AberDerBart/Floppotron-Jr/pcb/eurocad/README.md

## Eurocad

Eurorack components and footprints for KiCad.

### Components

- [Eurorack 2x5 Power Header](http://www.doepfer.de/a100_man/a100t_e.htm)
- [HT16K33](https://cdn-shop.adafruit.com/datasheets/ht16K33v110.pdf)
- [LP4OA1PBCT](http://datasheet.elcodis.com/pdf/19/45/194534/lp4oa1pbctr.pdf)
- [MCP23017](https://cdn-shop.adafruit.com/datasheets/mcp23017.pdf)
- [PJ301M-12](https://www.thonk.co.uk/wp-content/uploads/2014/02/Thonkiconn_Jack_Datasheet.pdf)
- [SN74HC165](http://www.ti.com/lit/ds/symlink/sn74hc165.pdf)
- [SN74HC595](http://www.ti.com/lit/ds/symlink/sn74hc595.pdf)
- [TLC5925](http://www.ti.com/lit/ds/symlink/tlc5925.pdf)
- [TL1105SPF250Q](http://spec_sheets.e-switch.com/specs/J100206.pdf)
- [B3W9](http://www.mouser.com/ds/2/307/en-b3w-9-11824.pdf)
- [RGBLED10mm](https://cdn-shop.adafruit.com/datasheets/FLR-100WAS-RGB.pdf)
- [BA56](http://www.kingbrightusa.com/images/catalog/SPEC/BA56-12SRWA.pdf)
- [7805](https://www.sparkfun.com/datasheets/Components/LM7805.pdf)
- 2x8 0.1" Pin Header
- 2x5 0.1" Pin Header
- 2x4 0.1" Pin Header

### Footprints

- [LP4OA1PBCT](http://datasheet.elcodis.com/pdf/19/45/194534/lp4oa1pbctr.pdf)
- [PJ301M-12](https://www.thonk.co.uk/wp-content/uploads/2014/02/Thonkiconn_Jack_Datasheet.pdf)
- [TL1105SPF250Q](http://spec_sheets.e-switch.com/specs/J100206.pdf)
- [B3W9](http://www.mouser.com/ds/2/307/en-b3w-9-11824.pdf)
- [Alpha9mmPot](https://www.thonk.co.uk/documents/alpha/9mm/Alpha%209mm%20Vertical%20-%20Linear%20Taper%20B1M.pdf)
- [RGBLED10mm](https://cdn-shop.adafruit.com/datasheets/FLR-100WAS-RGB.pdf)
- [BA56](http://www.kingbrightusa.com/images/catalog/SPEC/BA56-12SRWA.pdf)
- [DC_JACK](https://www.sparkfun.com/datasheets/Prototyping/Barrel-Connector-PJ-202A.pdf)
- MIDI DIN 5
- Mouse Bites (1mm apart, 0.5mm diameter)
