AberDerBart/Floppotron-Jr/case/case.scad

$fn=32;
FLOPPY_SIZE = [101.6,25.4];
N_FLOPPIES = 6;

D_PIEZO = 30; // 27mm piezo disk + 1.5mm padding

Z_PCB = 10 + FLOPPY_SIZE.y * 6 + 3;
X_BORDER = (125 - FLOPPY_SIZE.x)/2;

module kosmoPanel2d(w, old_hole_style=true) {
  difference(){
    square([w,200]);
    if (old_hole_style) {
      for (p = [
        [5, 5],
        [5, 195],
        [w-5, 5],
        [w-5, 195],
      ]) {
        translate(p) circle(d=3.2);
      }
    }else{
      for (p = [
        [4.5, 3],
        [4.5, 197],
        [w-4.5, 3],
        [w-4.5, 197],
      ]) {
        translate(p) hull(){
          translate([-1.5,0])circle(d=3.2);
          translate([1.5,0])circle(d=3.2);
        }
      }
    }
  }
}

module ports2d(usb=true) {
  // ports on the pcb, measured form the bottom of the PCB
  if(usb) translate([18,0]) 
    // USB port, measured from Pin 1, bottom of PCB
    translate([-7.41, 1.6+0.3])square([12.319, 10.6]);
  translate([37, 1.6+9.75]) circle(d=18);
}

module labels2d() {
  translate([133,187.5]) text("MOD",5, "JetBrainsMono Nerd Font:style=SemiBold", halign="right", valign="center");
  translate([133,162.5]) text("VEL",5, "JetBrainsMono Nerd Font:style=SemiBold", halign="right", valign="center");

  translate([133,112.5]) text("TRIG",5, "JetBrainsMono Nerd Font:style=SemiBold", halign="right", valign="center");
  translate([133,87.5]) text("GATE",5, "JetBrainsMono Nerd Font:style=SemiBold", halign="right", valign="center");

  translate([133,37.5]) text("OUT",5, "JetBrainsMono Nerd Font:style=SemiBold", halign="right", valign="center");
}

module frontPanel2d(interface=false, usb=true) {
  difference(){
    kosmoPanel2d(interface ? 150: 125);
    translate([X_BORDER, 10])square([FLOPPY_SIZE.x, FLOPPY_SIZE.y * N_FLOPPIES]);
    translate([X_BORDER, Z_PCB]) ports2d(usb=usb);
    if (interface) {
      for(y=[25,75,100,150,175]){
        translate([137.5,y]) circle(d=11.2);
      }
      for(y=[87.5,112.5,162.5,187.5]){
        translate([137.5,y]) circle(d=5);
      }
    }
  }
}


module side2d() {
  difference(){
    hull(){
      translate([90,15])circle(r=5);
      translate([85,10 + N_FLOPPIES * FLOPPY_SIZE.y])circle(r=10);
      translate([0, 180])circle(r=10);
      translate([0, 20])circle(r=10);
    }
    for(i = [0:N_FLOPPIES - 1]){
      for(x = [25, 85]){
        translate([x, 5 + 10 + i * FLOPPY_SIZE.y]) circle(d=3);
      }
    }
    translate([-11,0])square([11,200]);
  }
}

module pcbMount2d() {
  difference(){
    union(){
      translate([X_BORDER, 0, 0])square([8.8,95]);
      translate([X_BORDER+FLOPPY_SIZE.x-8.8, 0, 0])square([8.8,95]);
    }
    translate([125/2, 3])
      for(pos = [
        [46, 4],
        [-46, 4],
        [+46, 92 - 4],
        [-46, 92 - 4],
      ])
    {
      translate(pos)circle(d=2.8);
    }
  }
}

module piezoHole2d(){
  circle(d=D_PIEZO);
}

module piezoCover(){
  difference(){
    translate([0,0,3])mirror([0,0,1])linear_extrude(3, scale=1+(2*3/D_PIEZO)){
      difference(){
        piezoHole2d();
        hull(){
          translate([12,0,0])circle(d=5);
          translate([18,0,0])circle(d=6);
        }
      }
    }
  }
}

module cableGuideBridge() {
  translate([0,0,-.5])cube([2,5,1], center=true);
}

module cableGuideHole2d() {
  square([6,3],center=true);
}

module rightWall() {
  module forEachPiezo(){
      for(i = [0:2]){
        translate([48, (1+2*i) * FLOPPY_SIZE.y + 10]) children();
      }
  }

  module forEachCableGuide(){
    for(i = [2:4]){
      translate([75, i * FLOPPY_SIZE.y + 10])children();
    }
  }

  translate([125-X_BORDER,0,0])rotate([90,0,90]){
    linear_extrude(3)difference(){
      side2d();
      forEachPiezo()piezoHole2d();
      forEachCableGuide()cableGuideHole2d();
    }
    translate([0,0,3]){
      forEachPiezo()piezoCover();
      forEachCableGuide()cableGuideBridge();
    }
  }
}

module case(interface = false, usb=true){
  difference(){
    union(){
      rotate([90,0,0])translate([0,0,-3])linear_extrude(3)frontPanel2d(interface=interface, usb=usb);
      translate([X_BORDER-3,0,0])rotate([90,0,90])linear_extrude(3)side2d();
      rightWall();
      translate([0,0,Z_PCB-3])linear_extrude(3)pcbMount2d();
    }
    rotate([90,0,0])translate([0,0,-1])linear_extrude(2)labels2d();
  }
}

case(interface=true, usb=false);
