AberDerBart/Floppotron-Jr/pcb/floppotron/floppotron.kicad_pcb

## KiCad design pcb/floppotron/floppotron.kicad_pcb (2024-12-11)

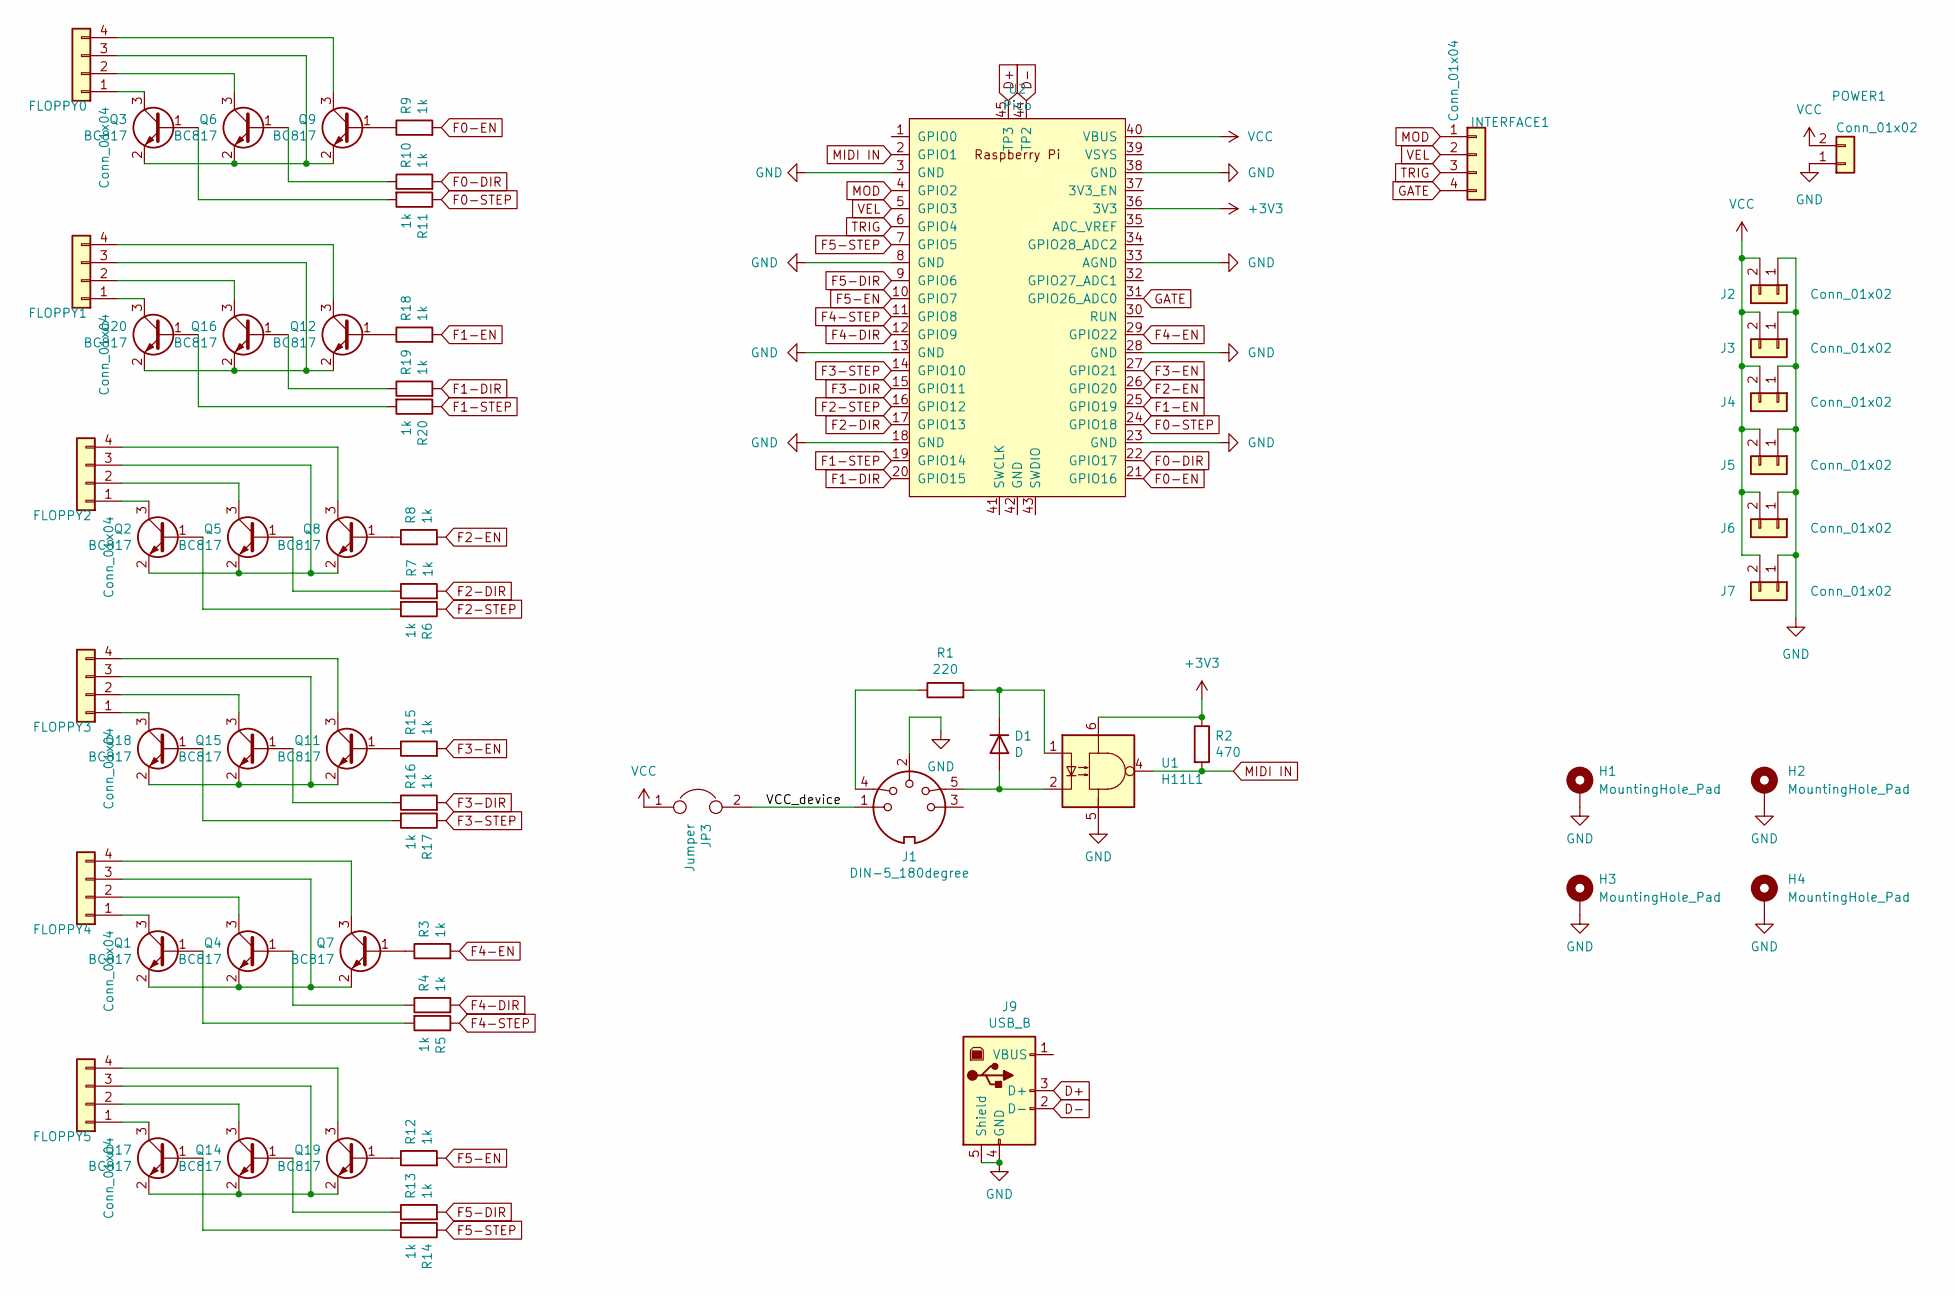
[picture p3: schematic floppotron.kicad_sch]

Parts:
D1: D; D_DO-34_SOD68_P7.62mm_Horizontal
FLOPPY0, FLOPPY1, FLOPPY2, FLOPPY3, FLOPPY4, FLOPPY5: Conn_01x04; JST_XH_B4B-XH-A_1x04_P2.50mm_Vertical
H1, H2, H3, H4: MountingHole_Pad; MountingHole_3.2mm_M3_DIN965_Pad
INTERFACE1: Conn_01x04; JST_XH_B4B-XH-A_1x04_P2.50mm_Vertical
J1: DIN-5_180degree; MIDI_DIN5
J2, J3, J4, J5, J6, J7: Conn_01x02; JST_XH_B2B-XH-A_1x02_P2.50mm_Vertical
J9: USB_B; USB_B_OST_USB-B1HSxx_Horizontal
JP3: Jumper; PinHeader_1x02_P2.54mm_Vertical
POWER1: Conn_01x02; TerminalBlock_bornier-2_P5.08mm
Q1, Q2, Q3, Q4, Q5, Q6, Q7, Q8, Q9, Q11, Q12, Q14, Q15, Q16, Q17, Q18, Q19, Q20: BC817; SOT-23_Handsoldering
R1: 220; R_1206_3216Metric_Pad1.30x1.75mm_HandSolder
R2: 470; R_1206_3216Metric_Pad1.30x1.75mm_HandSolder
R3, R4, R5, R6, R7, R8, R9, R10, R11, R12, R13, R14, R15, R16, R17, R18, R19, R20: 1k; R_1206_3216Metric_Pad1.30x1.75mm_HandSolder
U1: H11L1; DIP-6_W7.62mm_Socket
U2: Pico; RPi_Pico_debug_hole_USB_SMD_TH

Connections:
+3V3: R2.1, U1.6, U2.36 (3V3)
/VCC_device: J1.1, JP3.2
D+: J9.3 (D+), U2.45 (TP3)
D-: J9.2 (D-), U2.44 (TP2)
F0-DIR: R10.2, U2.22 (GPIO17)
F0-EN: R9.2, U2.21 (GPIO16)
F0-STEP: R11.1, U2.24 (GPIO18)
F1-DIR: R19.2, U2.20 (GPIO15)
F1-EN: R18.2, U2.25 (GPIO19)
F1-STEP: R20.1, U2.19 (GPIO14)
F2-DIR: R7.2, U2.17 (GPIO13)
F2-EN: R8.2, U2.26 (GPIO20)
F2-STEP: R6.1, U2.16 (GPIO12)
F3-DIR: R16.2, U2.15 (GPIO11)
F3-EN: R15.2, U2.27 (GPIO21)
F3-STEP: R17.1, U2.14 (GPIO10)
F4-DIR: R4.2, U2.12 (GPIO9)
F4-EN: R3.2, U2.29 (GPIO22)
F4-STEP: R5.1, U2.11 (GPIO8)
F5-DIR: R13.2, U2.9 (GPIO6)
F5-EN: R12.2, U2.10 (GPIO7)
F5-STEP: R14.1, U2.7 (GPIO5)
GATE: INTERFACE1.4, U2.31 (GPIO26_ADC0); also elsewhere on the board
GND: H1.1, H2.1, H3.1, H4.1, J1.2, J2.1, J3.1, J4.1, J5.1, J6.1, J7.1, J9.4 (GND), J9.5 (Shield), POWER1.1, U1.5, U2.3 (GND), U2.8 (GND), U2.13 (GND), U2.18 (GND), U2.23 (GND), U2.28 (GND), U2.33 (AGND), U2.38 (GND)
MIDI IN: R2.2, U1.4, U2.2 (GPIO1)
MOD: INTERFACE1.1, U2.4 (GPIO2); also elsewhere on the board
unnamed: D1.2 (A), J1.5, U1.2
unnamed: D1.1 (K), R1.2, U1.1
unnamed: FLOPPY0.1, Q3.3 (C)
unnamed: FLOPPY0.2, Q6.3 (C)
unnamed: FLOPPY0.3, Q3.2 (E), Q6.2 (E), Q9.2 (E)
unnamed: FLOPPY0.4, Q9.3 (C)
unnamed: FLOPPY1.1, Q20.3 (C)
unnamed: FLOPPY1.2, Q16.3 (C)
unnamed: FLOPPY1.3, Q12.2 (E), Q16.2 (E), Q20.2 (E)
unnamed: FLOPPY1.4, Q12.3 (C)
unnamed: FLOPPY2.1, Q2.3 (C)
unnamed: FLOPPY2.2, Q5.3 (C)
unnamed: FLOPPY2.3, Q2.2 (E), Q5.2 (E), Q8.2 (E)
unnamed: FLOPPY2.4, Q8.3 (C)
unnamed: FLOPPY3.1, Q18.3 (C)
unnamed: FLOPPY3.2, Q15.3 (C)
unnamed: FLOPPY3.3, Q11.2 (E), Q15.2 (E), Q18.2 (E)
unnamed: FLOPPY3.4, Q11.3 (C)
unnamed: FLOPPY4.1, Q1.3 (C)
unnamed: FLOPPY4.2, Q4.3 (C)
unnamed: FLOPPY4.3, Q1.2 (E), Q4.2 (E), Q7.2 (E)
unnamed: FLOPPY4.4, Q7.3 (C)
unnamed: FLOPPY5.1, Q17.3 (C)
unnamed: FLOPPY5.2, Q14.3 (C)
unnamed: FLOPPY5.3, Q14.2 (E), Q17.2 (E), Q19.2 (E)
unnamed: FLOPPY5.4, Q19.3 (C)
unnamed: J1.4, R1.1
unnamed: Q1.1 (B), R5.2
unnamed: Q2.1 (B), R6.2
unnamed: Q3.1 (B), R11.2
unnamed: Q4.1 (B), R4.1
unnamed: Q5.1 (B), R7.1
unnamed: Q6.1 (B), R10.1
unnamed: Q7.1 (B), R3.1
unnamed: Q8.1 (B), R8.1
unnamed: Q9.1 (B), R9.1
unnamed: Q11.1 (B), R15.1
unnamed: Q12.1 (B), R18.1
unnamed: Q14.1 (B), R13.1
unnamed: Q15.1 (B), R16.1
unnamed: Q16.1 (B), R19.1
unnamed: Q17.1 (B), R14.2
unnamed: Q18.1 (B), R17.2
unnamed: Q19.1 (B), R12.1
unnamed: Q20.1 (B), R20.2
TRIG: INTERFACE1.3, U2.6 (GPIO4); also elsewhere on the board
VCC: J2.2, J3.2, J4.2, J5.2, J6.2, J7.2, JP3.1, POWER1.2, U2.40 (VBUS)
VEL: INTERFACE1.2, U2.5 (GPIO3); also elsewhere on the board

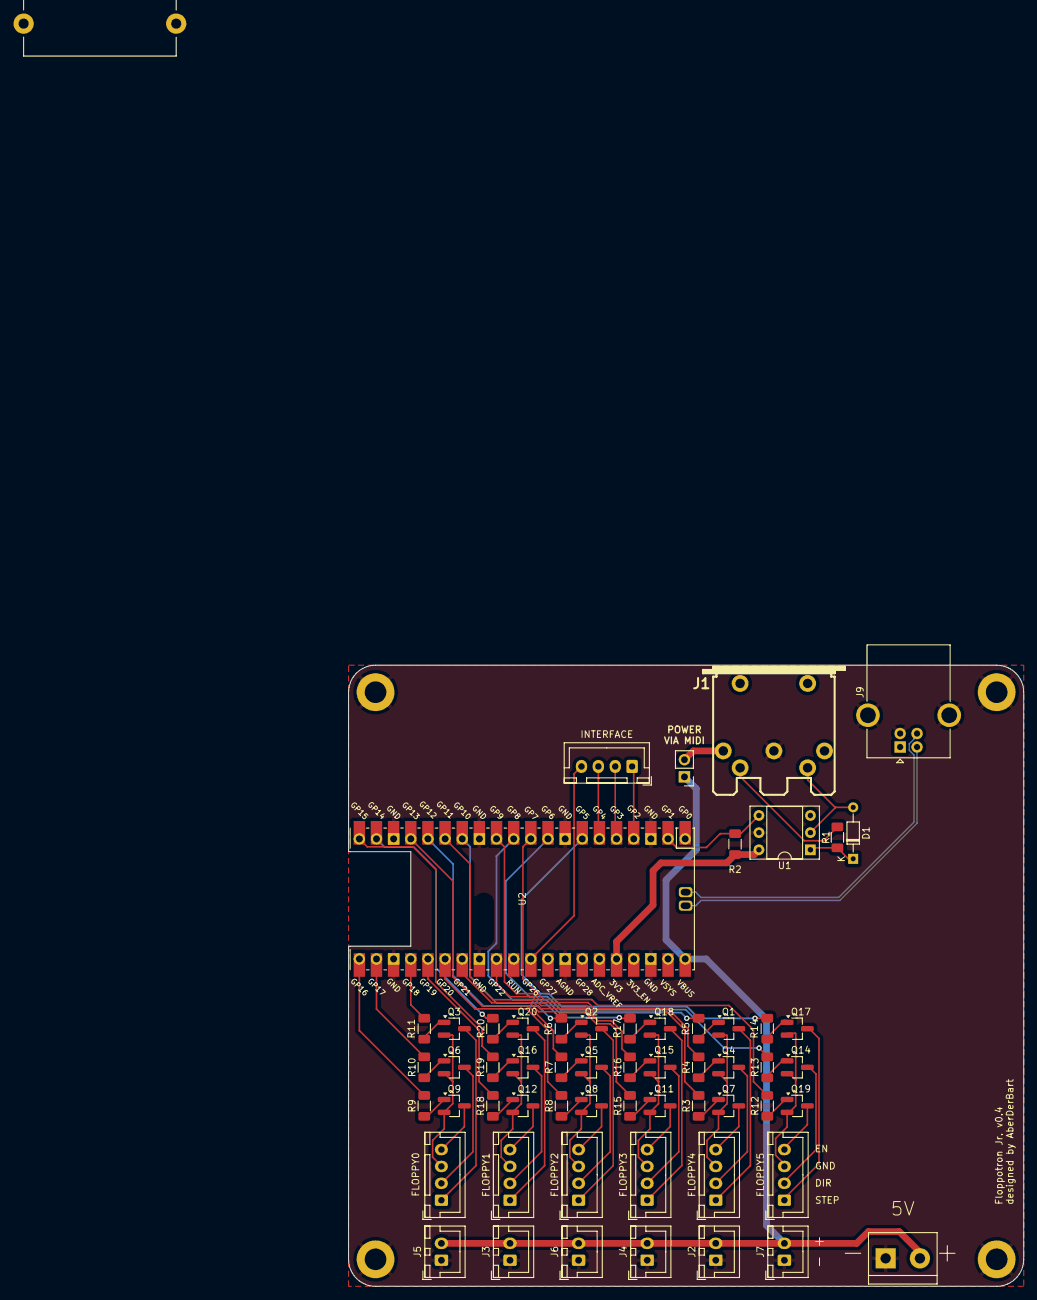
[picture p4: board floppotron.kicad_pcb from above]

Board: 2 copper layers, 100.0 x 92.0 mm, 63 parts (0 on the bottom side), 74 nets.

Other parts of the board:
F1: Fuse; Fuseholder_Cylinder-5x20mm_Stelvio-Kontek_PTF78_Horizontal_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
INTERFACE: Conn_01x04; JST_XH_B4B-XH-A_1x04_P2.50mm_Vertical

Their connections:
GATE: INTERFACE.4; also elsewhere on the board
MOD: INTERFACE.1; also elsewhere on the board
TRIG: INTERFACE.3; also elsewhere on the board
VEL: INTERFACE.2; also elsewhere on the board
