AberDerBart/Floppotron-Jr/pcb/kosmo-interface/kosmo-interface.kicad_pcb

## KiCad design pcb/kosmo-interface/kosmo-interface.kicad_pcb (2024-12-11)

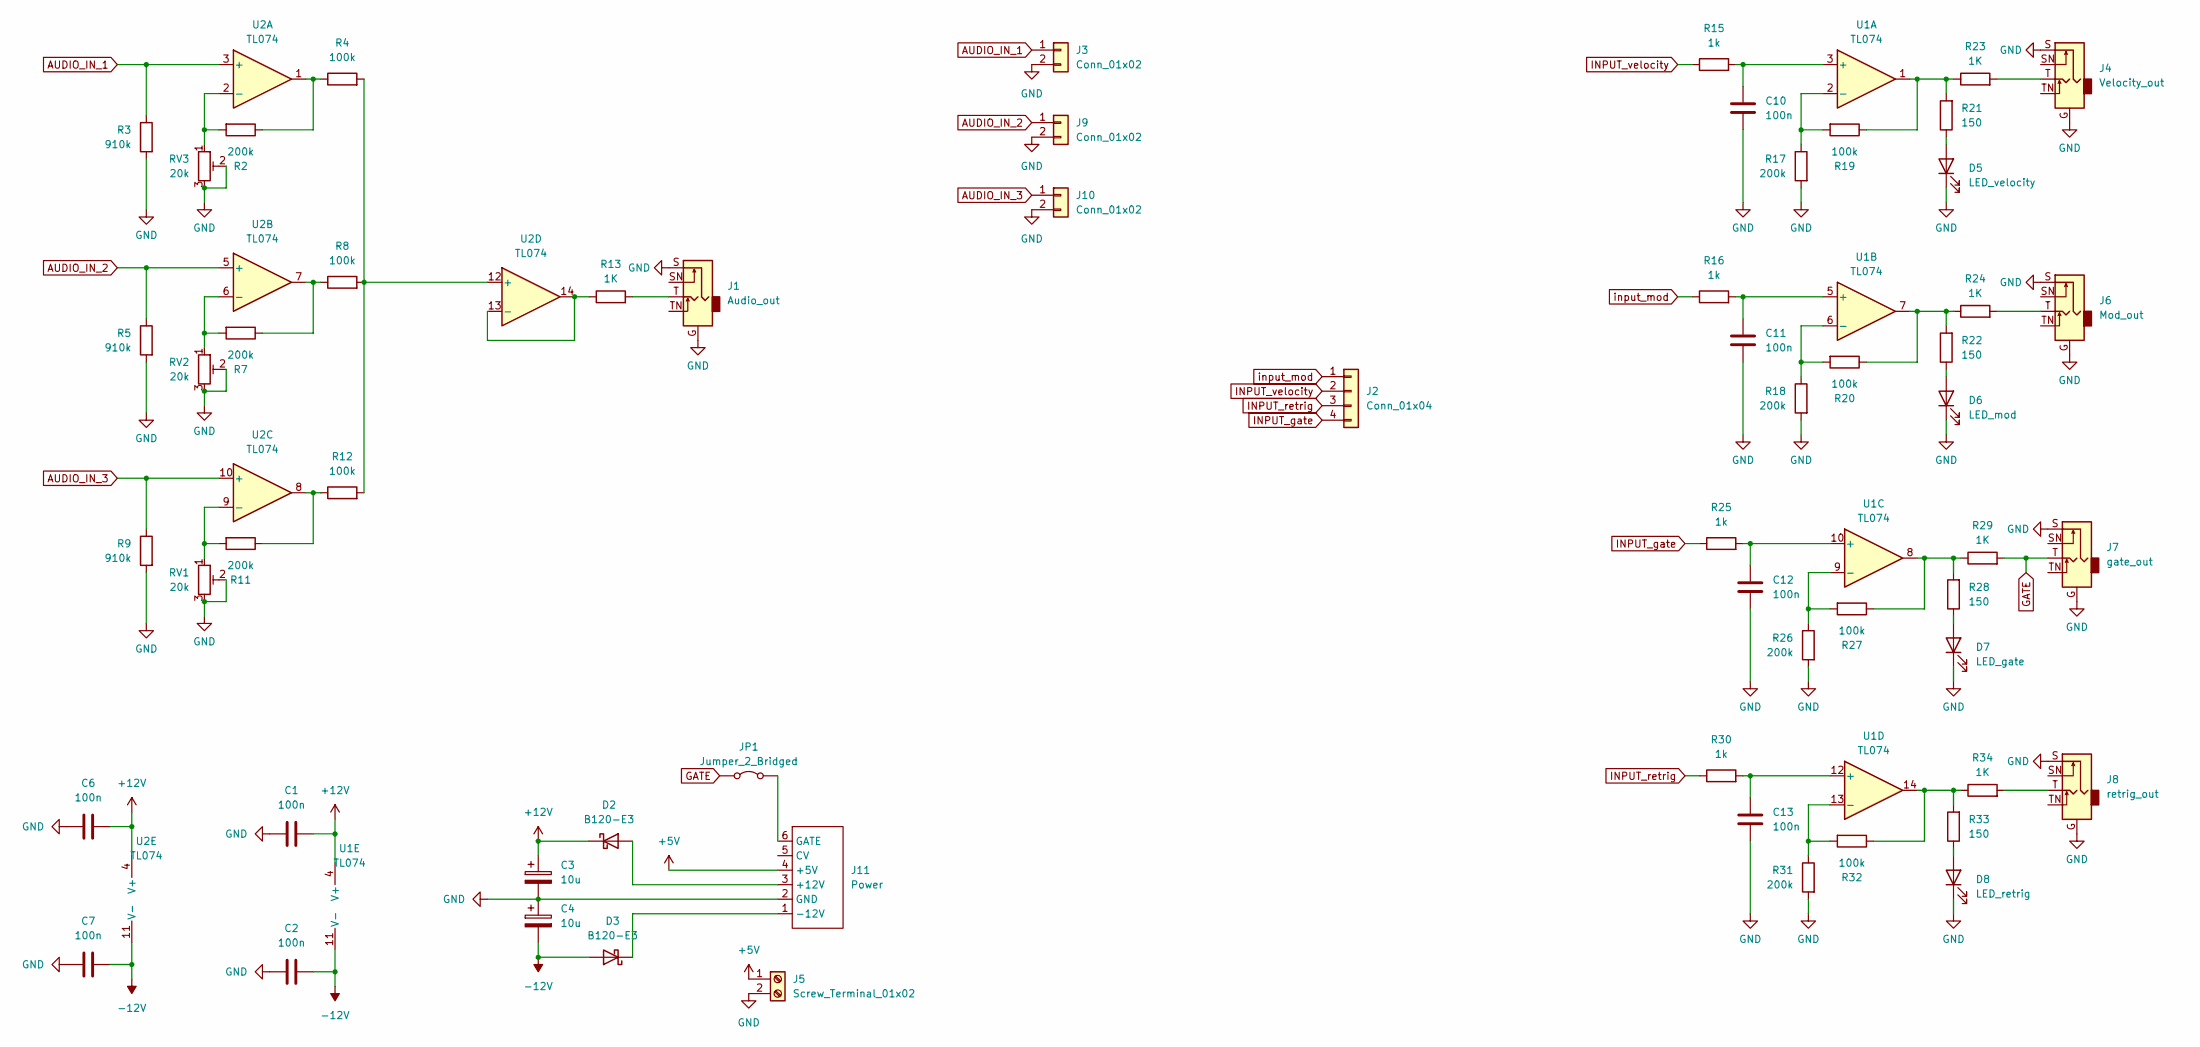
[picture p5: schematic kosmo-interface.kicad_sch]

Parts:
C1, C2, C6, C7, C10, C11, C12, C13: 100n; C_1206_3216Metric_Pad1.33x1.80mm_HandSolder
C3, C4: 10u; CP_Radial_D8.0mm_P3.50mm
D2, D3: B120-E3; D_SMA
D5: LED_velocity; LED_5mm_side_centered
D6: LED_mod; LED_5mm_side_centered
D7: LED_gate; LED_5mm_side_centered
D8: LED_retrig; LED_5mm_side_centered
J1: Audio_out; jack-neutrik-horizontal
J2: Conn_01x04; JST_XH_B4B-XH-A_1x04_P2.50mm_Vertical
J3, J9, J10: Conn_01x02; JST_XH_B2B-XH-A_1x02_P2.50mm_Vertical
J4: Velocity_out; jack-neutrik-horizontal
J5: Screw_Terminal_01x02; TerminalBlock_MetzConnect_Type055_RT01502HDWU_1x02_P5.00mm_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
J6: Mod_out; jack-neutrik-horizontal
J7: gate_out; jack-neutrik-horizontal
J8: retrig_out; jack-neutrik-horizontal
J11: Power; Power 16 Pin
JP1: Jumper_2_Bridged; SolderJumper-2_P1.3mm_Open_RoundedPad1.0x1.5mm
R2, R7, R11, R17, R18, R26, R31: 200k; R_1206_3216Metric_Pad1.30x1.75mm_HandSolder
R3, R5, R9: 910k; R_1206_3216Metric_Pad1.30x1.75mm_HandSolder
R4, R8, R12, R19, R20, R27, R32: 100k; R_1206_3216Metric_Pad1.30x1.75mm_HandSolder
R13, R23, R24, R29, R34: 1K; R_1206_3216Metric_Pad1.30x1.75mm_HandSolder
R15, R16, R25, R30: 1k; R_1206_3216Metric_Pad1.30x1.75mm_HandSolder
R21, R22, R28, R33: 150; R_1206_3216Metric_Pad1.30x1.75mm_HandSolder
RV1, RV2, RV3: 20k; Potentiometer_Bourns_3296W_Vertical
U1: TL074; DIP-14_W7.62mm
U2: TL074

Connections:
+5V: J5.1, J11.4 (+5V)
+12V: C1.2, C3.1, C6.2, D2.1 (K), U1.4 (V+), U2.4 (V+)
-12V: C2.2, C4.2, C7.2, D3.2 (A), U1.11 (V-), U2.11 (V-)
AUDIO_IN_1: J3.1, R3.1, U2.3 (+)
AUDIO_IN_2: J9.1, R5.1, U2.5 (+)
AUDIO_IN_3: J10.1, R9.1, U2.10 (+)
GATE: J7.T, JP1.1 (A), R29.2
GND: C1.1, C2.1, C3.2, C4.1, C6.1, C7.1, C10.2, C11.2, C12.2, C13.2, D5.1 (K), D6.1 (K), D7.1 (K), D8.1 (K), J1.G, J1.S, J3.2, J4.G, J4.S, J5.2, J6.G, J6.S, J7.G, J7.S, J8.G, J8.S, J9.2, J10.2, J11.2 (GND), R3.2, R5.2, R9.2, R17.2, R18.2, R26.2, R31.2, RV1.2, RV1.3, RV2.2, RV2.3, RV3.2, RV3.3
INPUT_gate: J2.4, R25.1
INPUT_retrig: J2.3, R30.1
INPUT_velocity: J2.2, R15.1
unnamed: D2.2 (A), J11.3 (+12V)
unnamed: D3.1 (K), J11.1 (-12V)
unnamed: D5.2 (A), R21.1
unnamed: D6.2 (A), R22.1
unnamed: D7.2 (A), R28.1
unnamed: D8.2 (A), R33.1
unnamed: J1.T, R13.2
unnamed: J4.T, R23.2
unnamed: J6.T, R24.2
unnamed: J8.T, R34.2
unnamed: J11.6 (GATE), JP1.2 (B)
unnamed: R2.1, R4.1, U2.1
unnamed: R7.1, R8.1, U2.7
unnamed: R11.1, R12.1, U2.8
unnamed: R19.1, R21.2, R23.1, U1.1
unnamed: R20.1, R22.2, R24.1, U1.7
unnamed: R27.1, R28.2, R29.1, U1.8
unnamed: R32.1, R33.2, R34.1, U1.14
unnamed: C10.1, R15.2, U1.3 (+)
unnamed: R17.1, R19.2, U1.2 (-)
unnamed: C11.1, R16.2, U1.5 (+)
unnamed: R18.1, R20.2, U1.6 (-)
unnamed: C12.1, R25.2, U1.10 (+)
unnamed: R26.1, R27.2, U1.9 (-)
unnamed: C13.1, R30.2, U1.12 (+)
unnamed: R31.1, R32.2, U1.13 (-)
unnamed: R2.2, RV3.1, U2.2 (-)
unnamed: R7.2, RV2.1, U2.6 (-)
unnamed: R11.2, RV1.1, U2.9 (-)
unnamed: R4.2, R8.2, R12.2, U2.12 (+)
unnamed: R13.1, U2.13 (-), U2.14
input_mod: J2.1, R16.1

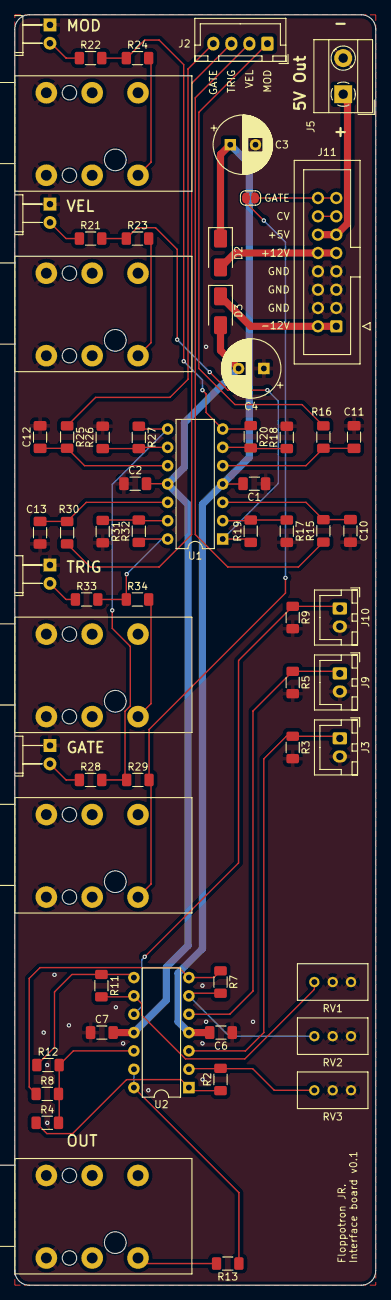
[picture p6: board kosmo-interface.kicad_pcb from above]

Board: 2 copper layers, 50.0 x 176.0 mm, 63 parts (0 on the bottom side), 43 nets.
