AberDerBart/Floppotron-Jr/firmware-c/noteDict.h

#include <stdint.h>

struct pwmSetting {
  uint16_t wrap;
  uint8_t clk_div;
  uint16_t wrap_pb_up;
};

struct pwmSetting noteDict[] = {
    {65338, 117, 61671},  // C-1
    {65004, 111, 61356},  // C#-1
    {65485, 104, 61810},  // D-1
    {64932, 99, 61287},   // D#-1
    {65241, 93, 61580},   // E-1
    {65079, 88, 61426},   // F-1
    {65126, 83, 61471},   // F#-1
    {65412, 78, 61740},   // G-1
    {65078, 74, 61425},   // G#-1
    {64935, 70, 61291},   // A-1
    {65005, 66, 61357},   // A#-1
    {65315, 62, 61649},   // B-1
    {64784, 59, 61148},   // C0
    {64424, 56, 60808},   // C#0
    {65485, 52, 61810},   // D0
    {64282, 50, 60675},   // D#0
    {64547, 47, 60925},   // E0
    {65079, 44, 61426},   // F0
    {64351, 42, 60739},   // F#0
    {65412, 39, 61740},   // G0
    {65078, 37, 61425},   // G#0
    {64935, 35, 61291},   // A0
    {65005, 33, 61357},   // A#0
    {65315, 31, 61649},   // B0
    {63704, 30, 60129},   // C1
    {64424, 28, 60808},   // C#1
    {65485, 26, 61810},   // D1
    {64282, 25, 60675},   // D#1
    {63203, 24, 59655},   // E1
    {65079, 22, 61426},   // F1
    {64351, 21, 60739},   // F#1
    {63776, 20, 60197},   // G1
    {63365, 19, 59809},   // G#1
    {63131, 18, 59588},   // A1
    {63093, 17, 59552},   // A#1
    {63274, 16, 59723},   // B1
    {63704, 15, 60129},   // C2
    {64424, 14, 60808},   // C#2
    {65485, 13, 61810},   // D2
    {61810, 13, 58341},   // D#2
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
};
