AberDerBart/Floppotron-Jr/firmware-c/cvOutput.h

#ifndef ANALOG_OUT_H
#define ANALOG_OUT_H

#include <stdbool.h>
#include <stdint.h>

void out_init();

void set_velocity(uint8_t velocity);

void set_mod(uint8_t mod);

void pulse_trig();

void set_gate(bool gate);

#endif
