AberDerBart/Floppotron-Jr/firmware-c/midi.c

#include "midi.h"

#include <stdbool.h>
#include <stdint.h>

#include "hardware/gpio.h"
#include "hardware/uart.h"

#define UART_ID uart0
#define BAUD_RATE 31250
#define MIDI_OUT_PIN 0
#define MIDI_IN_PIN 1

#define PACKET_BYTE_TIMEOUT_US 50

void midi_init() {
  uart_init(UART_ID, BAUD_RATE);
  gpio_set_function(MIDI_OUT_PIN, GPIO_FUNC_UART);
  gpio_set_function(MIDI_IN_PIN, GPIO_FUNC_UART);
}

void midi_write(uint8_t cmd, uint8_t b1, uint8_t b2) {
  uart_putc(UART_ID, cmd);
  uart_putc(UART_ID, b1);
  uart_putc(UART_ID, b2);
}

bool midi_is_status_byte(uint8_t byte) { return (byte & 0x80) == 0x80; }

struct midi_packet midi_read() {
  struct midi_packet packet;

  packet.status = 0;

  while (!midi_is_status_byte(packet.status)) {
    packet.status = uart_getc(UART_ID);
  }

  packet.b1 = uart_getc(UART_ID);
  packet.b2 = uart_getc(UART_ID);

  return packet;
}

bool midi_try_read(struct midi_packet *packet) {
  packet->status = 0;

  while (!midi_is_status_byte(packet->status)) {
    if (!uart_is_readable(UART_ID)) {
      return false;
    }
    packet->status = uart_getc(UART_ID);
  }

  if (!uart_is_readable_within_us(UART_ID, PACKET_BYTE_TIMEOUT_US)) {
    return false;
  }
  packet->b1 = uart_getc(UART_ID);

  if (!uart_is_readable_within_us(UART_ID, PACKET_BYTE_TIMEOUT_US)) {
    return false;
  }
  packet->b2 = uart_getc(UART_ID);

  return true;
}
