AberDerBart/Floppotron-Jr/(commit log)

2022-03-25 implement oscillator configuration switching
    [floppy.rs, inverse.rs, oscillators.rs, single.rs]
2022-03-25 stop oscillators before freeing them
    [inverse.rs, single.rs, unisono.rs]
2022-03-25 generalize calling functions on all oscillators
    [oscillators.rs]
2022-11-05 add case
    [case.scad]
2022-11-05 add piezos to case
    [case.scad]
2022-11-09 change toolchain
    [picoprobe.cfg, rp2040.cfg]
2022-11-09 ignore stl and 3mf files
2022-11-09 add pcb
    [floppotron.kicad_pcb, floppotron.kicad_sch, floppotron.sch, piezo_amp.kicad_sch]
2022-11-11 firmware: notedict: remove debug prints
2024-05-14 redesign pcb for pico W
    [case.scad, floppotron.kicad_pcb, floppotron.kicad_sch, piezo_amp.kicad_sch]
2024-05-14 clean up case code
    [case.scad]
2024-05-14 pcb: add kosmo power connector
    [floppotron.kicad_pcb, floppotron.kicad_sch]
2024-05-14 clean up traces
    [floppotron.kicad_pcb, floppotron.kicad_sch]
2024-12-11 pcb: add interface board
    [kosmo-interface.kicad_pcb, kosmo-interface.kicad_sch]
2024-12-11 pcb: adapt for interface board
    [floppotron.kicad_pcb, floppotron.kicad_sch]
2024-12-11 case: adapt for kosmo interface
    [case.scad]
2024-12-12 case: add labels
    [case.scad]
2024-12-18 firmware-c: consistently use pwm slice from oscillator struct
    instead of using index sometimes.
    this allows to decouple the oscillators indices from the slice indices
    [main.c, oscillator.c, oscillator.h]
2024-12-18 firmware-c: re-assign oscillator pwm slices
    [oscillator.c]
2024-12-18 firmware-c: implement modulation wheel CC
2024-12-18 firmware-c: use switch/case for midi statu
2024-12-18 firmware-c: implement velocity output
2025-01-03 firmware-c: fix overflow in pitchbend/note offset calculation
    [oscillator.c]
2025-03-10 firmware-c: inititalize floppy head position on powerup
